pa3hcm/loom-warping-peg/peg_cap.stl

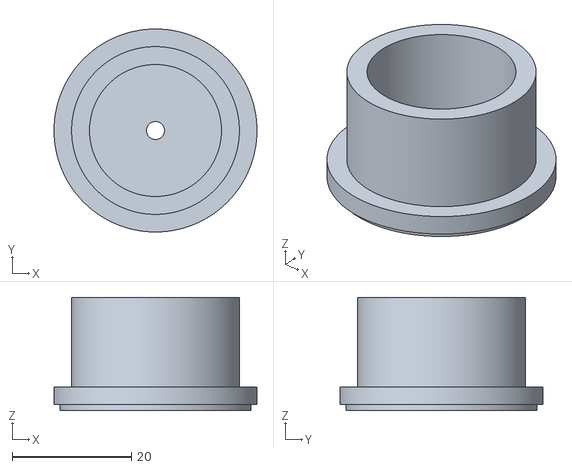
[picture p3: CAD file, 2026-11-07]
peg_cap.stl
34.0 x 34.0 x 19.0
