pa3hcm/loom-warping-peg/peg_base.stl

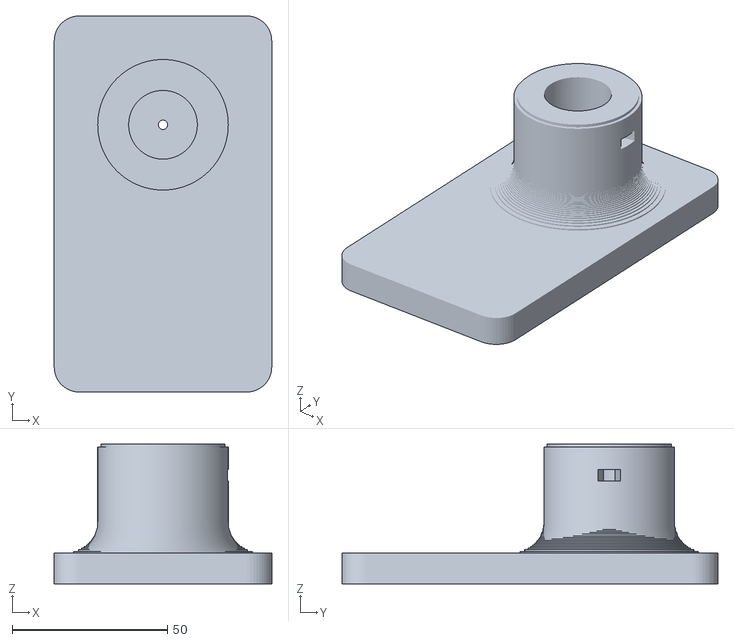
[picture p4: CAD file, 2026-11-07]
peg_base.stl
70.0 x 121.0 x 45.0
